nkeita1204/lr_noda/README.md

# 12bitのキャパシタ型DAC

- CDAC:CDAC_PNSW2
- ボルテージフォロワ:OPAmpP2
- テストベンチ:CDAC_Amp_sim
- CDACの動作原理やDNL/INLの測定方法はCDAC動作説明.pdfを参照
