nkeita1204/lr_noda/Xschem/Documents/op8_22_v2.sch.md

(不使用)
- Camenzind氏のrair to railOPAを基にした回路
- スルーレートが足りず、不使用
