nkeita1204/lr_noda/Documents/1024Cu.sch.md

(不使用)

- 512Cuが並列になった回路
- 詳細は2Cu.schのmarkdown参照
