nkeita1204/lr_noda/Documents/128Cu.sch.md

(不使用)

- 64Cuが並列になった回路
- 詳細は2Cu.schのmarkdown参照
