nkeita1204/lr_noda/Documents/16Cu.sch.md

(不使用)

- 8Cuが並列になった回路
- 詳細は2Cu.schのmarkdown参照
