nkeita1204/lr_noda/Documents/2048Cu.sch.md

(不使用)

- 1024Cuが並列になった回路
- 詳細は2Cu.schのmarkdown参照
