nkeita1204/lr_noda/Documents/256Cu.sch.md

(不使用)

- 128Cuが並列になった回路
- 詳細は2Cu.schのmarkdown参照
