nkeita1204/lr_noda/Documents/2Cu.sch.md

(不使用)

- Cunitが2つ並列になった回路。
- Cを並列にすると2Cとなり、Ronを並列にすると(1/2)Ronになるため、回路全体の時定数(RC)が一定のまま、Cを大きくできる。
- Cunitを編集すれば、容量値とトランジスタのパラメータを全体で一括で変更できるが、インスタンス数が多くなるため、Sim時間が長くなるので今回は不使用。
