nkeita1204/lr_noda/Documents/32Cu.sch.md

(不使用)

- 16Cuが並列になった回路
- 詳細は2Cu.schのmarkdown参照
