nkeita1204/lr_noda/Documents/4Cu.sch.md

（不使用)

- 2Cuが並列になった回路
- 詳細は2Cu.schのmarkdown参照
