nkeita1204/lr_noda/Documents/512Cu.sch.md

(不使用)

- 256Cuが並列になった回路
- 詳細は2Cu.schのmarkdown参照
