nkeita1204/lr_noda/Documents/64Cu.sch.md

(不使用)

- 32Cuが並列になった回路
- 詳細は2Cu.schのmarkdown参照
