nkeita1204/lr_noda/Documents/8Cu.sch.md

(不使用)

- 4Cuが並列になった回路
- 詳細は2Cu.schのmarkdown参照
