nkeita1204/lr_noda/Documents/CDAC_CMOSSW.sch.md

(不使用)
- CMOSスイッチを用いたCDAC
- 直流入力のため、オン抵抗の変動による非線形性を考慮しなくてよいので、CMOSスイッチ不要のため不使用
