nkeita1204/lr_noda/Documents/CDAC_PNSW.sch.md

(不使用)
- 並列接続したCunitを用いた、VrefhにPMOS、VreflにNMOSを用いたCDAC
- シミュレーション時間が長くなるため不使用
