nkeita1204/lr_noda/Documents/CDAC_PNSW2.sch.md

（使用)
- VrefhにPMOS、VreflにNMOSスイッチを用いた構成
- シミュレーション時間短縮のために、Cとトランジスタのm(Multiplier)を用いて並列にした
- ノンオーバーラップクロック生成回路と、リセット時もしくはPD時の制御信号を生成する回路、入力信号から制御信号を生成するIMPLYゲートがある。
