nkeita1204/lr_noda/Documents/CDAC_sim.sch.md

- CDACのみのシミュレーション用回路
- 入力はCDAC_Amp_simと同じ
