nkeita1204/lr_noda/Documents/CMOSSW.sch.md

(不使用)
- PMOSとNMOSを並列にしたスイッチの構成
- スイッチのオン抵抗は入力依存性を持ち、PMOSとNMOSは特性が逆なので、オン抵抗の変化を補い合うことで、入力依存性を低減する。
