nkeita1204/lr_noda/Documents/Cunit.sch.md

(不使用)
- キャパシタとスイッチ2つがユニットになった回路。キャパシタとスイッチを並列に接続するためにこのようにユニットを作成する。○Cuが並列接続した回路。
- リファレンス電圧VrefhがPMOS、VreflがNMOS(オン抵抗が低いため)。
- キャパシタは現在は4um×4um。
