nkeita1204/lr_noda/Documents/IMPLY.sch.md

（使用)
- IMPLYゲート論理回路
- 入力信号からスイッチの制御信号を生成するときに必要
- インバータ(NOT)とORで構成
- PMOSとNMOSのスイッチを用いるため、この回路が必要になる
