nkeita1204/lr_noda/Documents/INV.sch.md

(使用)
- CMOSインバータ(NOTゲート)回路
- デジタルの入力を反転する。1→0 0→1
