nkeita1204/lr_noda/Documents/INV_sim.sch.md

- インバータの検証用回路
- DC解析により、インバータのしきい値などを検証できる
