nkeita1204/lr_noda/Documents/NOL.sch.md

(使用)
- スイッチトキャパシタを用いるときは、すべてのスイッチがオフになる期間が必要となる。その期間を設けたクロックをノンオーバラップクロックという。
- ノンオーバラップクロックを生成する回路は、NOR回路と、遅延用のインバータによって構成される。
