nkeita1204/lr_noda/Documents/NOL_sim.sch.md

- ノンオーバーラップ回路の検証用回路
- クロックを入力し、MEASUREコマンドを用いて、２つの出力クロックが両方オフになる時間を測定
