nkeita1204/lr_noda/Documents/OPAmp_sim_SR.sch.md

- オペアンプのスルーレート測定用回路
- パルス信号を入力して、オペアンプの応答速度を測定
