nkeita1204/lr_noda/Documents/OPAmpP.sch.md

(不使用)
- PMOS入力の2段オペアンプ
- トランジスタのサイズ変更のため不使用
