nkeita1204/lr_noda/Documents/OPAmpP2.sch.md

(使用)
- P入力の2段オペアンプ
- VDDに近い入力電圧のときの安定性に課題が残る
