nkeita1204/lr_noda/Documents/railtorailOPAmp.sch.md

(不使用)
レイルツーレイルのオペアンプの原理理解のためのPとN入力のオペアンプを並列に接続した回路
