nkeita1204/lr_noda/DNLINL/Documents/undefined.md

DNLとINLを算出するpythonコード
- wrdataで出力したテキストファイルを読み込む
- データファイルはデータが非常に大きいため、計算に使ったデータのみを間引いて新たに出力する機能付き
- もとのデータは手動削除
