nkeita1204/lr_noda/DNLINL/extracted_test5.txt

Time[s] Voltage[V]
1.900000e-07 2.970392e-01
3.900000e-07 2.975073e-01
5.900000e-07 2.979725e-01
7.900000e-07 2.984377e-01
9.900000e-07 2.989036e-01
1.190000e-06 2.993680e-01
1.390000e-06 2.998334e-01
1.590000e-06 3.002986e-01
1.790000e-06 3.007638e-01
1.990000e-06 3.012292e-01
2.190000e-06 3.016943e-01
2.390000e-06 3.021599e-01
2.590000e-06 3.026247e-01
2.790000e-06 3.030904e-01
2.990000e-06 3.035555e-01
3.190000e-06 3.040210e-01
3.390000e-06 3.044859e-01
3.590000e-06 3.049514e-01
3.790000e-06 3.054159e-01
3.990000e-06 3.058822e-01
4.190000e-06 3.063454e-01
4.390000e-06 3.068121e-01
4.590000e-06 3.072772e-01
4.790000e-06 3.077422e-01
4.990000e-06 3.082047e-01
5.190000e-06 3.086745e-01
5.390000e-06 3.091379e-01
5.590000e-06 3.096053e-01
5.790000e-06 3.100664e-01
5.990000e-06 3.105360e-01
6.190000e-06 3.109987e-01
6.390000e-06 3.114637e-01
6.590000e-06 3.119191e-01
6.790000e-06 3.123872e-01
6.990000e-06 3.128490e-01
7.190000e-06 3.133172e-01
7.390000e-06 3.137828e-01
7.590000e-06 3.142474e-01
7.790000e-06 3.147094e-01
7.990000e-06 3.151775e-01
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
