nkeita1204/lr_noda/DNLINL/extracted_test6.txt

Time[s] Voltage[V]
1.800000e-07 2.983796e-01
3.800000e-07 2.988394e-01
5.800000e-07 2.993030e-01
7.800000e-07 2.997674e-01
9.800000e-07 3.002296e-01
1.180000e-06 3.006966e-01
1.380000e-06 3.011594e-01
1.580000e-06 3.016250e-01
1.780000e-06 3.020889e-01
1.980000e-06 3.025530e-01
2.180000e-06 3.030176e-01
2.380000e-06 3.034814e-01
2.580000e-06 3.039437e-01
2.780000e-06 3.044097e-01
2.980000e-06 3.048745e-01
3.180000e-06 3.053284e-01
3.380000e-06 3.057902e-01
3.580000e-06 3.062643e-01
3.780000e-06 3.067308e-01
3.980000e-06 3.071927e-01
4.180000e-06 3.076573e-01
4.380000e-06 3.081228e-01
4.580000e-06 3.085870e-01
4.780000e-06 3.090515e-01
4.980000e-06 3.095193e-01
5.180000e-06 3.099770e-01
5.380000e-06 3.104439e-01
5.580000e-06 3.109058e-01
5.780000e-06 3.113756e-01
5.980000e-06 3.118345e-01
6.180000e-06 3.123017e-01
6.380000e-06 3.127652e-01
6.580000e-06 3.132167e-01
6.780000e-06 3.136961e-01
6.980000e-06 3.141475e-01
7.180000e-06 3.146250e-01
7.380000e-06 3.150888e-01
7.580000e-06 3.155536e-01
7.780000e-06 3.160083e-01
7.980000e-06 3.164824e-01
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
