nkeita1204/lr_noda/DNLINL/extracted_test.txt

Time[s] Voltage[V]
1.800000e-07 2.970109e-01
3.800000e-07 2.974810e-01
5.800000e-07 2.979467e-01
7.800000e-07 2.984123e-01
9.800000e-07 2.988789e-01
1.180000e-06 2.993437e-01
1.380000e-06 2.998091e-01
1.580000e-06 3.002748e-01
1.780000e-06 3.007407e-01
1.980000e-06 3.012065e-01
2.180000e-06 3.016718e-01
2.380000e-06 3.021379e-01
2.580000e-06 3.026023e-01
2.780000e-06 3.030691e-01
2.980000e-06 3.035342e-01
3.180000e-06 3.040005e-01
3.380000e-06 3.044674e-01
3.580000e-06 3.049321e-01
3.780000e-06 3.053960e-01
3.980000e-06 3.058637e-01
4.180000e-06 3.063254e-01
4.380000e-06 3.067940e-01
4.580000e-06 3.072592e-01
4.780000e-06 3.077245e-01
4.980000e-06 3.081847e-01
5.180000e-06 3.086591e-01
5.380000e-06 3.091216e-01
5.580000e-06 3.095908e-01
5.780000e-06 3.100491e-01
5.980000e-06 3.105225e-01
6.180000e-06 3.109843e-01
6.380000e-06 3.114492e-01
6.580000e-06 3.118964e-01
6.780000e-06 3.123698e-01
6.980000e-06 3.128263e-01
7.180000e-06 3.133003e-01
7.380000e-06 3.137672e-01
7.580000e-06 3.142315e-01
7.780000e-06 3.146881e-01
7.980000e-06 3.151623e-01
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
