nkeita1204/lr_noda/DNLINL/extracted_test2.txt

Time[s] Voltage[V]
1.900000e-07 2.983517e-01
3.900000e-07 2.988135e-01
5.900000e-07 2.992776e-01
7.900000e-07 2.997421e-01
9.900000e-07 3.002050e-01
1.190000e-06 3.006705e-01
1.390000e-06 3.011349e-01
1.590000e-06 3.015991e-01
1.790000e-06 3.020628e-01
1.990000e-06 3.025271e-01
2.190000e-06 3.029915e-01
2.390000e-06 3.034556e-01
2.590000e-06 3.039202e-01
2.790000e-06 3.043841e-01
2.990000e-06 3.048485e-01
3.190000e-06 3.053076e-01
3.390000e-06 3.057701e-01
3.590000e-06 3.062396e-01
3.790000e-06 3.067048e-01
3.990000e-06 3.071682e-01
4.190000e-06 3.076333e-01
4.390000e-06 3.080974e-01
4.590000e-06 3.085616e-01
4.790000e-06 3.090261e-01
4.990000e-06 3.094917e-01
5.190000e-06 3.099535e-01
5.390000e-06 3.104190e-01
5.590000e-06 3.108823e-01
5.790000e-06 3.113488e-01
5.990000e-06 3.118112e-01
6.190000e-06 3.122768e-01
6.390000e-06 3.127409e-01
6.590000e-06 3.132011e-01
6.790000e-06 3.136683e-01
6.990000e-06 3.141325e-01
7.190000e-06 3.145971e-01
7.390000e-06 3.150613e-01
7.590000e-06 3.155258e-01
7.790000e-06 3.159916e-01
7.990000e-06 3.164546e-01
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
