nkeita1204/lr_noda/DNLINL/extracted_test3.txt

Time[s] Voltage[V]
1.900000e-07 2.983783e-01
3.900000e-07 2.988402e-01
5.900000e-07 2.993043e-01
7.900000e-07 2.997688e-01
9.900000e-07 3.002317e-01
1.190000e-06 3.006973e-01
1.390000e-06 3.011617e-01
1.590000e-06 3.016260e-01
1.790000e-06 3.020898e-01
1.990000e-06 3.025540e-01
2.190000e-06 3.030185e-01
2.390000e-06 3.034826e-01
2.590000e-06 3.039473e-01
2.790000e-06 3.044112e-01
2.990000e-06 3.048757e-01
3.190000e-06 3.053349e-01
3.390000e-06 3.057974e-01
3.590000e-06 3.062669e-01
3.790000e-06 3.067321e-01
3.990000e-06 3.071956e-01
4.190000e-06 3.076607e-01
4.390000e-06 3.081248e-01
4.590000e-06 3.085891e-01
4.790000e-06 3.090537e-01
4.990000e-06 3.095193e-01
5.190000e-06 3.099811e-01
5.390000e-06 3.104466e-01
5.590000e-06 3.109101e-01
5.790000e-06 3.113765e-01
5.990000e-06 3.118390e-01
6.190000e-06 3.123046e-01
6.390000e-06 3.127688e-01
6.590000e-06 3.132293e-01
6.790000e-06 3.136961e-01
6.990000e-06 3.141607e-01
7.190000e-06 3.146250e-01
7.390000e-06 3.150892e-01
7.590000e-06 3.155537e-01
7.790000e-06 3.160196e-01
7.990000e-06 3.164826e-01
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
