nkeita1204/lr_noda/DNLINL/extracted_test4.txt

Time[s] Voltage[V]
1.900000e-07 1.181491e-02
3.900000e-07 1.180062e-02
5.900000e-07 1.178648e-02
7.900000e-07 1.177256e-02
9.900000e-07 1.175886e-02
1.190000e-06 1.174535e-02
1.390000e-06 1.173205e-02
1.590000e-06 1.171893e-02
1.790000e-06 1.170599e-02
1.990000e-06 1.169323e-02
2.190000e-06 1.168063e-02
2.390000e-06 1.166820e-02
2.590000e-06 1.165592e-02
2.790000e-06 1.164380e-02
2.990000e-06 1.163182e-02
3.190000e-06 1.161997e-02
3.390000e-06 1.160826e-02
3.590000e-06 1.159668e-02
3.790000e-06 1.158522e-02
3.990000e-06 1.157389e-02
4.190000e-06 1.156268e-02
4.390000e-06 1.155158e-02
4.590000e-06 1.154059e-02
4.790000e-06 1.152970e-02
4.990000e-06 1.151892e-02
5.190000e-06 1.150823e-02
5.390000e-06 1.149765e-02
5.590000e-06 1.148715e-02
5.790000e-06 1.147675e-02
5.990000e-06 1.146643e-02
6.190000e-06 1.145620e-02
6.390000e-06 1.144606e-02
6.590000e-06 1.143595e-02
6.790000e-06 1.142595e-02
6.990000e-06 1.141604e-02
7.190000e-06 1.140619e-02
7.390000e-06 1.139641e-02
7.590000e-06 1.138670e-02
7.790000e-06 1.137706e-02
7.990000e-06 1.136748e-02
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
